MikhaelKaa/Z80Kaa/README.md

# Z80Kaa

# Компьютер-конструктор на базе процессора Z80. Общее описание

## Введение:
Данный конструктор основанн на процессоре Z80 и статической памяти.

Этот компьютер создан для изучения ассемблера Z80.

## Компоненты:
  
### 1. Процессор Z80:
 - Назначение: Основное вычислительное устройство.
  
### 2. Статическая память M48Z35:
  - Назначение: Оперативная и постоянная память.
  - Объем: 32768 байт.
  - Характеристики: Хранение данных даже после выключения благодаря встроенной батарее.
  
### 3. CPLD EPM3032:
  - Назначение: Генерация тактовой частоты процессора, сигналов INT и PWM, дешифрация экрана, строб опроса клавиатуры.
  
### 4. Экран LCD1602:
  - Назначение: Вывод информации.
  - Характеристики: Возможность отображения двух строк по 16 символов в каждой.
  - Подключение: К шине данных процессора и стробам из CPLD.
  
### 5. STM32F103C8T6 (Bluepill):
  - Назначение: USB-программатор.
  - Функции: Остановка, сброс процессора Z80; чтение и запись памяти M48Z35.
  - Возможно реализовать дополнительный функционал, например com port.

  Прототип:
