MikhaelKaa/Z80Kaa/Docs/readme.txt

Этот самодельный компьютер основан на процессоре Z80 и имеет несколько основных компонентов:
1. Процессор Z80: Является основным вычислительным устройством компьютера.
2. Статическая память M48Z35: Объемом 32768 байт, выполняет роль как ОЗУ, так и ПЗУ.
   Она подключается напрямую к шинам процессора и используется для хранения данных, которые сохраняются даже при выключении питания благодаря встроенной батарее.
3. CPLD EPM3032: Используется для генерации тактовой частоты процессора, сигналов INT и PWM, дешифрации экрана, а также для строба на опрос клавиатуры (до 8 кнопок).
4. Экран LCD1602: Подключается к шине данных процессора и стробам из CPLD. Он может выводить две строки по 16 символов каждая.
   Работает на *указать* портах, которые реализованы в CPLD.
5. STM32F103C8T6 (Bluepill): USB-программатор. Он обеспечивает возможность остановки и сброса процессора Z80, чтения и записи памяти M48Z35.

Питание: Осуществляется через внешний источник питания, MiniUSB.

# Компьютер-конструктор на базе процессора Z80. Общее описание

## Введение:
Данный конструктор основанн на процессоре Z80 и статической памяти.
Этот компьютер создан для изучения ассемблера Z80.

## Компоненты:
  
### 1. Процессор Z80:
  - Назначение: Основное вычислительное устройство.
  
### 2. Статическая память M48Z35:
  - Назначение: Оперативная и постоянная память.
  - Объем: 32768 байт.
  - Характеристики: Хранение данных даже после выключения благодаря встроенной батарее.
  
### 3. CPLD EPM3032:
  - Назначение: Генерация тактовой частоты процессора, сигналов INT и PWM, дешифрация экрана, строб опроса клавиатуры.
  
### 4. Экран LCD1602:
  - Назначение: Вывод информации.
  - Характеристики: Возможность отображения двух строк по 16 символов в каждой.
  - Подключение: К шине данных процессора и стробам из CPLD.
  
### 5. STM32F103C8T6 (Bluepill):
  - Назначение: USB-программатор.
  - Функции: Остановка, сброс процессора Z80; чтение и запись памяти M48Z35.
  - Возможно реализовать дополнительный функционал, например com port.

## Дополнительные ресурсы:
  - Для получения подробной информации о каждом компоненте и примеров их использования, пожалуйста, обратитесь к соответствующим руководствам и документации, которые прилагаются к каждому компоненту.
  - Рекомендуется ознакомиться с официальной документацией по процессору Z80 и другим компонентам, чтобы получить более полное понимание их работы и функций.

Надеюсь, данная информация поможет вам начать работу с самодельным компьютером на базе процессора Z80. Если у вас возникнут дополнительные вопросы, не стесняйтесь задавать. Удачи в вашем проекте!
