MikhaelKaa/Z80Kaa/Docs/ZX_BP_BBSRAM_SCH_VER_231230.pdf

# VCC 28 E

# IO4 16 IO3 18 IO2 19 IO1 20 IO0 21

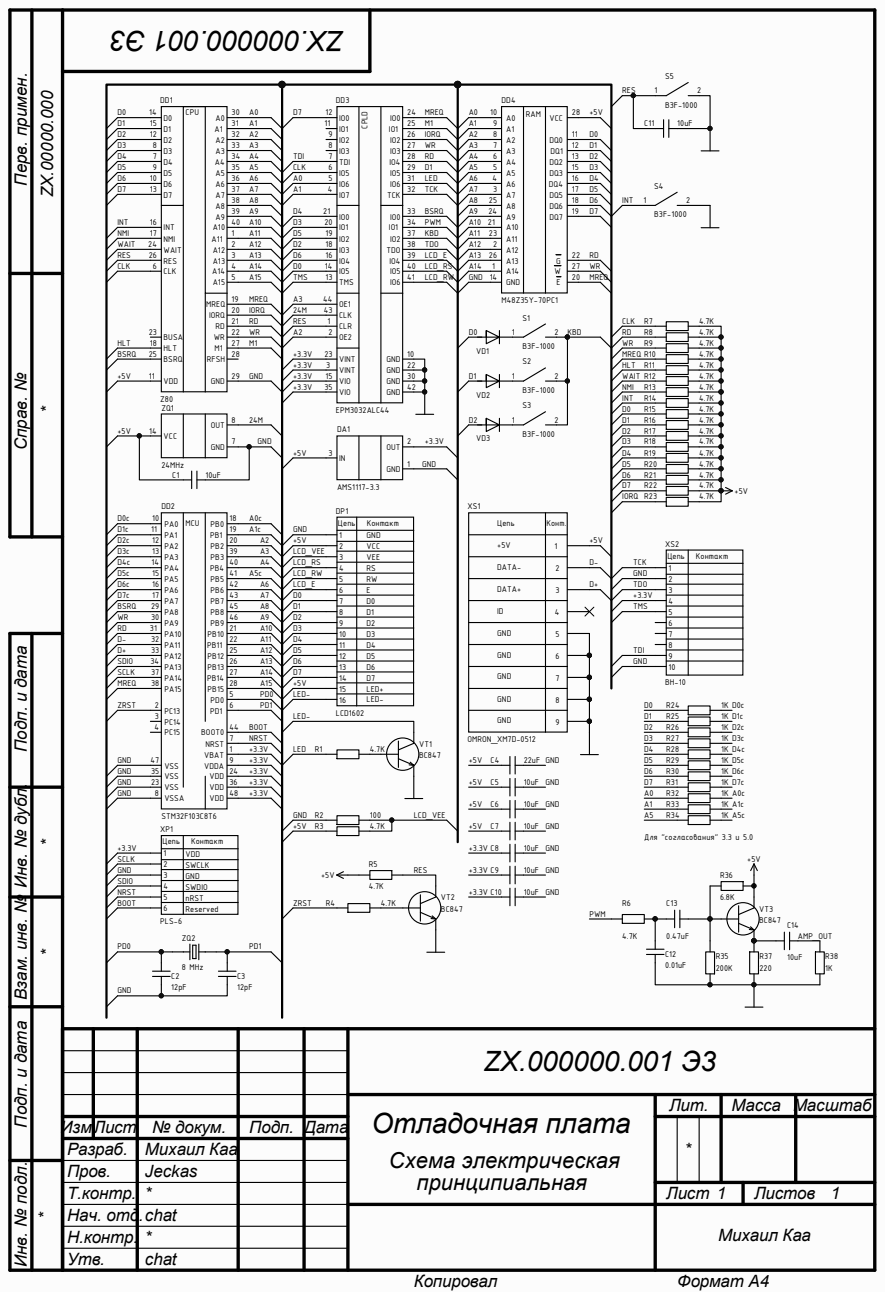
[picture p1: page 1]

Инв. № подл. Инв. № дубл. Подп. и дата Взам. инв. № Подп. и дата Перв. примен. Справ. №

Отладочная плата Схема электрическая принципиальная | Лит. | Масса Масштаб

Изм. | Лист | № докум. | Подп. Дата | | | *
Разраб. | | Михаил Каа
Пров. | Jeckas
Т.контр. | * | | | Лист 1 | Листов 1
Нач. отд.chat
Н.контр. | *
Утв. | chat
