MikhaelKaa/Z80Kaa/(list of files, drawings)

Other design files:
HW/src/main.SchDoc
HW/src/pcb.PcbDoc
HW/Z80Board.PrjPCB
