MikhaelKaa/Z80Kaa/ProgSTM32/Core/Src/main.c

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
/* Includes ------------------------------------------------------------------*/
#include "main.h"
#include "usb_device.h"
#include "gpio.h"

/* USER CODE BEGIN Includes */
#include <stdio.h>
#include "retarget.h"
#include "z80_ram.h"
#include "z80_ram_rw.h"
#include "prog.h"
#include "usbd_cdc_if.h"
/* USER CODE END Includes */


/* USER CODE BEGIN PV */
uint8_t rx1[2];
uint8_t control_cmd;
void control(uint8_t cmd);
/* USER CODE END PV */

void SystemClock_Config(void);
/**
  * @brief  The application entry point.
  * @retval int
  */
int main(void)
{
  /* MCU Configuration--------------------------------------------------------*/

  /* Reset of all peripherals, Initializes the Flash interface and the Systick. */
  HAL_Init();

  /* Configure the system clock */
  SystemClock_Config();

  /* Initialize all configured peripherals */
  MX_GPIO_Init();
  MX_USB_DEVICE_Init();
  /* USER CODE BEGIN 2 */
  HAL_Delay(10);
  //HAL_UART_Receive_DMA(&huart1, (uint8_t*)rx1, sizeof(rx1));
  prog_out = CDC_Transmit_FS;
  printf("Prog start\r\n");
  /* USER CODE END 2 */

  /* Infinite loop */
  /* USER CODE BEGIN WHILE */
  while (1)
  {
    for(int n = 0; n<655350; n++) asm("NOP");
    if(control_cmd != 0) control(control_cmd);
    //printf_flush();
    /* USER CODE END WHILE */

    /* USER CODE BEGIN 3 */
  }
  /* USER CODE END 3 */
}

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
/* USER CODE BEGIN 4 */
uint8_t block_read_buf[512] = {0};
void case_help(void);
void case_help(void) {
  printf("\
  h - tsis help message\r\n\
  i - init pins to work, z80 stopped\r\n\
  d - deinit pins to work z80 run\r\n\
  r - read\r\n\
  w - write\r\n\
  t - ram test\r\n\
  e - ram erase\r\n\
  b - block read\r\n\
  z - z80_cpu_reset\r\n\
  \r\n");
}
void control(uint8_t cmd) {

  // control cmd
  switch (cmd) {
    case 'i': z80_cpu_suspend(); break;
    case 'd': z80_cpu_resume(); break;
    case 'r': z80_ram_read_test(); break;
    case 'w': z80_ram_write_test(); break;
    case 't': z80_ram_test(); break;
    case 'e': z80_ram_erase_all(); break;
    case 'b': z80_ram_read_block(block_read_buf, 0, 32U) ; break;
    case 'z': z80_cpu_reset(); break;
    

    default: printf("Unknown cmd\r\n"); break;
  }
  control_cmd = 0;
}
/*
void (*uart_rx_callback)(uint8_t) = control;
void HAL_UART_RxCpltCallback(UART_HandleTypeDef *huart)
{
  if (huart->Instance == USART1) {
    uart_rx_callback(rx1[1]);
  }
}

void HAL_UART_RxHalfCpltCallback(UART_HandleTypeDef *huart)
{
  if (huart->Instance == USART1) {
    uart_rx_callback(rx1[0]);
  }
}
*/
/* USER CODE END 4 */
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
