MikhaelKaa/Z80Kaa/CPLD/src/Z80Kaa.v

module Z80Kaa (
// Main clock generator
input in_clock, // 24MHz

// Z80 CPU
output cpu_clock,
input	[7:0] data,
input [2:0] adr,
input rd,
input wr,
input iorq,
input mreq,
input m1,
input rst,
output intrpt,
// enable
input busrq,

// led & gpio
output led,
output gpio8,
output gpio9,

// LCD1602
output lcd_e,
output lcd_rw,
output lcd_rs,

// Keyboard
output KBD,

// pwm
output pwm
);

// io
wire iowr = iorq | wr ;//| ~m1;
wire iord = iorq | rd ;//| ~m1;
// lcd
wire port_lcd =  ~adr[1];
// keyboard
wire kbd_rd = (iord | ~(adr[1] & ~adr[0]));

// CPU clock & PWM cnt
reg [7:0] clk_pwm = 8'b0;
// register fe (gpio)
reg [7:0] reg_fe = 8'b0;
// register ff (PWM)
reg [7:0] reg_ff = 8'b0;

always@(negedge in_clock) begin
	clk_pwm = clk_pwm + 1'b1;
end

always @(negedge iowr) begin
	if(adr[1]) begin
		if(adr[0]) reg_ff = data;
		else reg_fe = data;
	end
end

// Z80 clock.
assign cpu_clock = clk_pwm[1];
// PWM
assign pwm    = reg_fe[1]?(reg_ff >= clk_pwm):(1'b1);
// Z80 Interrupt
assign intrpt = busrq?(~(clk_pwm == 0)):(1'b1);
// Keyboard
assign KBD    = busrq?((kbd_rd)?(1'bz):(1'b0)):(1'bz); // fe read
// LCD
assign lcd_e  = busrq?(~(iowr) & port_lcd):(1'b0);  // fd 
assign lcd_rw = busrq?(~adr[2]):(1'b0); // TODO: Read not tested
assign lcd_rs = busrq?(adr[0]):(1'b1);
assign led    = reg_fe[0];
// GPIO
assign gpio8  = reg_fe[2];
assign gpio9  = reg_fe[3];

endmodule
