MikhaelKaa/Z80Kaa/(commit log)

2023-11-02 >> Start.
    [Z80Board.PrjPCB, main.SchDoc, pcb.PcbDoc]
2023-11-02 >> Плата размером с кредитку.
    [main.SchDoc, pcb.PcbDoc]
2023-11-03 >> Эксперименты с альтиум
    [Z80Board.PrjPCB, main.SchDoc, pcb.PcbDoc]
2023-11-04 >> It's work!
    [Z80Board.PrjPCB, main.SchDoc, pcb.PcbDoc]
2023-11-05 >> 1602 не работает как нужно, процессор работает корректно.
    [Z80Board.PrjPCB, main.SchDoc, pcb.PcbDoc]
2023-11-05 >> Исправлена аппаратная ошибка, но изображения пока нет.
    [hello.asm]
2023-11-06 >> Its work!
    [main.SchDoc, pcb.PcbDoc]
2023-11-06 >> Z80Kaa проект выходного дня. Макетка работает.
2023-11-07 >> Похоже напортачил с .gitmodules
2023-11-07 >> Удалил submodule
2023-11-07 >> Добавил .gitmodules
2023-11-07 >> Добавлены кнопки на схему.
    [Z80Board.PrjPCB, main.SchDoc, pcb.PcbDoc]
2023-11-08 >> Заготовка под программатор.
    [main.SchDoc, pcb.PcbDoc]
2023-11-09 >> По низкому уровню на BUSRQ Z80 отдает управление шинами.
    [main.SchDoc, pcb.PcbDoc]
2023-11-09 >> Не работает, на адресной шине нет сигнала.
    [Z80Board.PrjPCB, main.SchDoc]
2023-11-10 >> Читает\пишет память BBSRAM, осталось протестировать с Z80.
2023-11-10 >> Устранена проблема с 5Vtolerant (костыль из резисторов 1к). Читает-пишет ок.
2023-11-10 >> Причесал код Z80RAMM
2023-11-11 >> Получилось в RAW режиме закинуть прошивку на BBSRAM, но это плохое решение.
2023-11-12 >> Версия с юартом пока будет основной.
2023-11-12 >> Продолжаю дорисовывать схему.
    [Z80Board.PrjPCB, main.SchDoc]
2023-11-12 >> Схема
    [Z80Board.PrjPCB, main.SchDoc]
2023-11-12 >> Добавлен набросок кода для программатора на стороне ПК
2023-11-13 >> Обмен данными между софтом на ПК и софтом на программаторе.
2023-11-14 >> Отладка на Nucleo, исправлены ошибки.
    [main.c, z80_bus_io.c, z80_bus_io.h, z80_cpu_ctrl.c, z80_ram.h, z80_ram_io.c]
2023-11-14 >> Первая корявая версия, которая загружает в отладочную плату бинарник.
2023-11-14 >> Очень нестабильно и коряво, но оно работает!
2023-11-15 >> Работает очень нестабильно.
2023-11-16 >> Новое расположение на ПП.
2023-11-19 >> BUSRQ устанавливает в CPLD безопасное состояние выходов.
    [main.SchDoc]
2023-11-22 >> Немного причесал схему, не особо читаема, но для начала пойдет.
    [main.SchDoc]
2023-11-24 >> Расположение компонентов на ПП. 80х190
2023-11-24 >> Программатор работает стабильно.
2023-11-24 >> Поубирал некоторые задержки, по прежнему работает. Надо сестировать.
2023-11-24 >> Удалил отладочный проект на большой стмке.
2023-11-26 >> Переделал работу с LCD1602.
2023-11-26 >> Даташиты.
2023-11-27 >> Работа с экраном вынесена в отдельный файл.
2023-11-27 >> Загрузка кастомных символов.
2023-11-29 >> Добавил на схему забытые резисторы для согласования 3.3 и 5
    [main.SchDoc]
2023-12-01 >> Черноевик варианта прошивки CPLD. Добавлен PWM 8 бит ~90kHz Добавлены gpio8 gpio9 Добавлен int ~90kHz
2023-12-01 >> 50 Commit. Нужно делать PCB.
2023-12-01 >> CPLD - почти готово, осталось только протестировать.
2023-12-01 >> Управление подсветкой экрана работает.
    [main.SchDoc]
2023-12-07 >> Версия с выводом звука через ШИМ 8Bit@93KHz, +часы
    [main.SchDoc]
2023-12-07 >> Расстановка компонентов.
    [Z80Board.PrjPCB, main.SchDoc]
2023-12-07 >> Начало трассировки платы. Выглядит не очень удачным.
    [Z80Board.PrjPCB, main.SchDoc]
2023-12-07 >> Трассировка, начало.
    [main.SchDoc]
2023-12-08 >> Трассировка.
2024-01-06 >> Добавлена схема электрическая принципиальная.
2024-02-17 >> Нужно рефакторить.
2024-03-07 >> Неработоспособная версия (стрим)
2024-03-07 >> стрим
2024-03-08 >> По крайней мере оно запускаеться.
2024-03-08 >> оно прыгает. все :)
2024-03-11 >> Добавлены файлы для прошивки stm32 через picoprobe
    [cmsis-dap.cfg, stlink.cfg, stm32f1x.cfg]
